Roberto-Garica-Sanchez/tesis/doc control PID.docx

Implementación control PID en Seguidor solar

Para controlar el seguidor solar ya tenemos el Angulo de la hora actual, derivado de los cálculos previamente expuestos, ahora es necesario hacer que el seguidor solar se posiciones en el Angulo para ello se requieres transmitirle esa información al motor y posicione correctamente.

Para lograr este objetivo se requiere la implementación un control PID (Proporcional Integral y Derivativo) que se encargara que el Angulo se mantenga constante y un sistema conversor que transmite los valores a la etapa de potencia que controla el motor (puente H)

El funcionamiento del PID depende de 2 variable de entrada

- Angulo deseado (Angulo de orientación solar)
- Angulo real (Angulo en el que el panel solar esta actualmente)

Estas variables son analógicas y pueden tomar valores que van desde 0 a 5 voltios

Para tal fin se hace uso del módulo analógico que los PIC integran, este modulo convierte el voltaje en una secuencia binaria, de 8 o 10 bits según se configure el módulo.

Según sea la cantidad de bits a utilizar, será mayor o menor la resolución de la lectura y por ende la precisión

Si utilizamos 8 bits solo podemos realizar 254 valores entre 0 a 5 voltios

En cambio 10 bits nos permiten 1024 valores entre 0 a 5 voltios

En este caso se usan 10 bits permitiendo mayor resolución y por ende mejor precisión.

Un inconveniente de usar este módulo, los valores almacenados en formato de bits, no son imprácticos al realizar todas las operaciones del PID que opera utiliza valores de tipo Float. Por lo tanto, se procede a convertir los bits en valores Float.

Para resolver este inconveniente se realizó la conversión de formato binario a Float al realizando una operación y obtener el voltaje y almacenarlo en el formato necesario utilizando la siguiente formula.

voltaje de entrada=(maximo voltaje de entrada*valor de lectura)/(resolucion)

voltaje de entra=(5v*lectura)/1024

################################definicion de PID

################################# ecuaciones PID

- e=error Actual
- k=número de muestra
- t=periodo de muestreo
- kp=Ganancia Proporcional
- ki=Ganancia integral
- kd=Ganancia derivativa
- u=resultado

(u_((s)))/(e_((s)))=[(k_p s+k_i)/s+k_d ]*s

(u_((s)))/(e_((s)))=(k_p s+k_i +k_d s^2)/s s=(1-z^(-1))/t

(u_((s)))/(e_((s)))=(k_p [(1-z^(-1))/t]+k_i +k_d [(1-z^(-1))/t]^2)/([(1-z^(-1))/t])

(u_((s)))/(e_((s)))=((k_p (1-z^(-1) )+k_i t)/t+k_d ((1-z^(-1) ))/t^2)/([(1-z^(-1))/t])

(u_((s)))/(e_((s)))=((k_p (1-z^(-1) )t^2 +k_i t^3 +k_d (1-z^(-1) )^2 t)/(t^3))/([(1-z^(-1))/t])

(u_((s)))/(e_((s)))=((k_p (1-z^(-1) )t^2 +k_i t^3 +k_d (1-z^(-1) )^2 t)/(t^2))/((1-z^(-1) ))

(u_((s)))/(e_((s)))=((k_p (1-z^(-1) )t^2)/(t^2)+(k_i t^3)/(t^2)+(k_d (1-z^(-1) )^2 t)/(t^2))/((1-z^(-1) ))

(u_((s)))/(e_((s)))=(k_p (1-z^(-1) )+k_i t+(k_d)/t(1-z^(-1) )^2)/((1-z^(-1) ))

(u_((s)))/(e_((s)))=(k_p (1-z^(-1) )+k_i t+(k_d)/t(1-2z^(-1) +z^(-2) ))/((1-z^(-1) ))

(u_((s)))/(e_((s)))=((k_p -k_p z^(-1) )+k_i t+((k_d)/t-2z^(-1) +(k_d)/tz^(-2) ))/((1-z^(-1) ))

(u_((s)))/(e_((s)))=((k_p +k_i t+(k_d)/t)+z^(-1) (-2(k_d)/t-k_p )+z^(-2) ((k_d)/t))/((1-z^(-1) ))

z^(-1) [(u_((s)))/(e_((s)))=((k_p +k_i t+(k_d)/t)+z^(-1) (-2(k_d)/t-k_p )+z^(-2) ((k_d)/t))/((1-z^(-1) ))]

z^(-1) [u_((s)) (1-z^(-1) )=e_((s)) ((k_p +k_i t+(k_d)/t)+z^(-1) (-2(k_d)/t-k_p )+z^(-2) ((k_d)/t))]

z^(-1) [u_((s)) -u_((s)) z^(-1) =e_((s)) (k_p +k_i t+(k_d)/t)+e_((s)) z^(-1) (-2(k_d)/t-k_p )+e_((s)) z^(-2) ((k_d)/t)]

u_([k]) -u_([k-1]) =e_([k]) (k_p +k_i t+(k_d)/t)+e_([k-1]) (-2(k_d)/t-k_p )+e_([k-2]) ((k_d)/t) u_([k]) =e_([k]) (k_p +k_i t+(k_d)/t)+e_([k-1]) (-2(k_d)/t-k_p )+e_([k-2]) ((k_d)/t)+u_([k-1])

################################definicion de etapa de potencia

#include <18F4550.h>

#device ADC=10

#fuses XT,NOWDT,NOPROTECT,NOLVP,PUT,BROWNOUT,INTRC_IO

#use delay(clock=4000000)

#INCLUDE <LCD.C>

#USE STANDARD_IO(A)

#USE STANDARD_IO(B)

#USE STANDARD_IO(C)

#USE STANDARD_IO(D)

#USE STANDARD_IO(E)

//configuraciones entradas/salidas

//entradas

#define PIN_SetPoint 0 //[AN0]Setpoint set_adc_channel(0);

#define PIN_PocitionReal 1 //[AN1]posicion real set_adc_channel(1);

//salidas

//control puente H

//comando de control de giro del motor

//set_pwm1_duty() [RC2]

//set_pwm1_duty() [RC3]

//variables tipo bits

unsigned int16 bits_SetPoint=0;

unsigned int16 bits_PocitionReal=0;

unsigned int16 bits_difer=0;

unsigned int16 bits_RES=0;

//variable control PWM

int16 duty=0;

int Timer2,Poscaler;

//variable control giro motor

int cambio, giro=1;//giro 1 si es negativos los valores

//######### PID

float Var_SetPoint=0;

float Var_PocitionReal=0;

float Var_error_0=0;

float Var_error_1=0;

float Var_error_2=0;

float a,b,c; //variables temporales

float t=1; //periodo de muestreo

int k=0; //contador de muestras

float Var_res_0; //Salidas

float Var_res_1; //Salidas

//######### ganancias

float kp=1; //proporcional

float kd=0.2; //Derivativa

float ki=0.2; //integral

vid main() {

Timer2=249; //Se carga Timer 2 con 249

Poscaler=1; //Preescaler solo puede tomar valores de: 1

//Configuración de Timer 2 para establecer frec. PWM a 1kHz

setup_timer_2(t2_div_by_4,Timer2,Poscaler);

setup_ccp1(ccp_pwm); //Configurar modulo CCP1 en modo PWM

setup_ccp2(ccp_pwm); //Configurar modulo CCP2 en modo PWM

//Configurar ADC configuración

//de los puertos que funcionan en analógico

setup_adc_ports(allánalo);

setup_adc(adc_clock_internal);

LCD_INIT(); //Inicializa el LCD

LCD_PUTC("\f"); //Borrar el contenido del LCD

while(true){

//leer Setpoint

set_adc_channel(PIN_SetPoint);//selecciona valore deseado setpoint

delay_us(100);

bits_SetPoint=read_adc();

//leer posición real

set_adc_channel(PIN_PocitionReal); //seleciona la posicion real

delay_us(100);

bits_PocitionReal=read_adc(); //leer

//cálculos

//convierte los bits en voltaje

Var_SetPoint = (5.0*bits_SetPoint)/1024.0;

Var_PocitionReal = (5.0*bits_PocitionReal)/1024.0;

bits_difer=bits_PocitionReal-bits_SetPoint;

//diferencia de voltaje

c=Var_PocitionReal-Var_SetPoint;

//PID cálculos

Var_error_2=Var_error_1;

Var_error_2=Var_error_0;

Var_error_0=Var_PocitionReal-Var_SetPoint;

//calculo

a=Var_error_0*( kp + (ki*t) )+( kd/t );

b=Var_error_1*( (-2*(kd/t) - kp) );

c=Var_error_2*( (kd/t) +Var_res_1 );

Var_res_1=Var_res_0;

Var_res_0=a+b+c;

//conversión para PWM

if(Var_res_0<0){//control de giro

Var_res_0=Var_res_0*-1;

giro=2;

}else{giro=1;}

if(Var_res_0>=4.90){//control contra desbordamiento

Var_res_0=4.99;

}

bits_RES = (1024*Var_res_0) /5;

//incremento en contador

k=k+1;

//interfaz

LCD_GOTOXY(1,1);

printf(lcd_putc," %4Lu",bits_difer); lcd_putc("b");

printf(lcd_putc," %f",Var_error_0); lcd_putc("V");

LCD_GOTOXY(1,2);

printf(lcd_putc," %4Lu",bits_RES); lcd_putc("b");

printf(lcd_putc," %f",Var_res_0); lcd_putc("V");

delay_ms(100);

LCD_PUTC("\f"); //Borrar el contenido del LCD

// EL SISGUIENTE CODIGO SE ENCARGA DE CONVERTIR

// el valor de salida del pid en valores validos

// para el puente h de dos hilos el sentido

// de giro se definirá por el signo ->0<+

if(Var_PocitionReal<Var_SetPoint){//valores positivos

c=Var_SetPoint-Var_PocitionReal;

set_pwm1_duty(bits_RES); //write salida de señal PWM

output_high(PIN_B1); //led indicador de giro

}else{

output_low(PIN_B1);

set_pwm1_duty(0);

}

if(Var_PocitionReal>Var_SetPoint){ //valores negativos

c=Var_PocitionReal-Var_SetPoint;

set_pwm2_duty(bits_RES); //write salida de señal PWM

output_high(PIN_B2); //led indicador de giro

}else{

output_low(PIN_B2);

set_pwm2_duty(0);

} //si el sentido de giro no corresponde apaga el led y PWM

if(Var_SetPoint==Var_PocitionReal){

set_pwm2_duty(0);

set_pwm1_duty(0);

}

}

}
