Roberto-Garica-Sanchez/tesis/observasiones doc tesis.docx

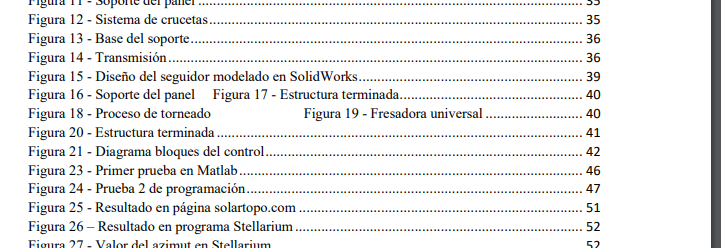
[picture p4: figure]
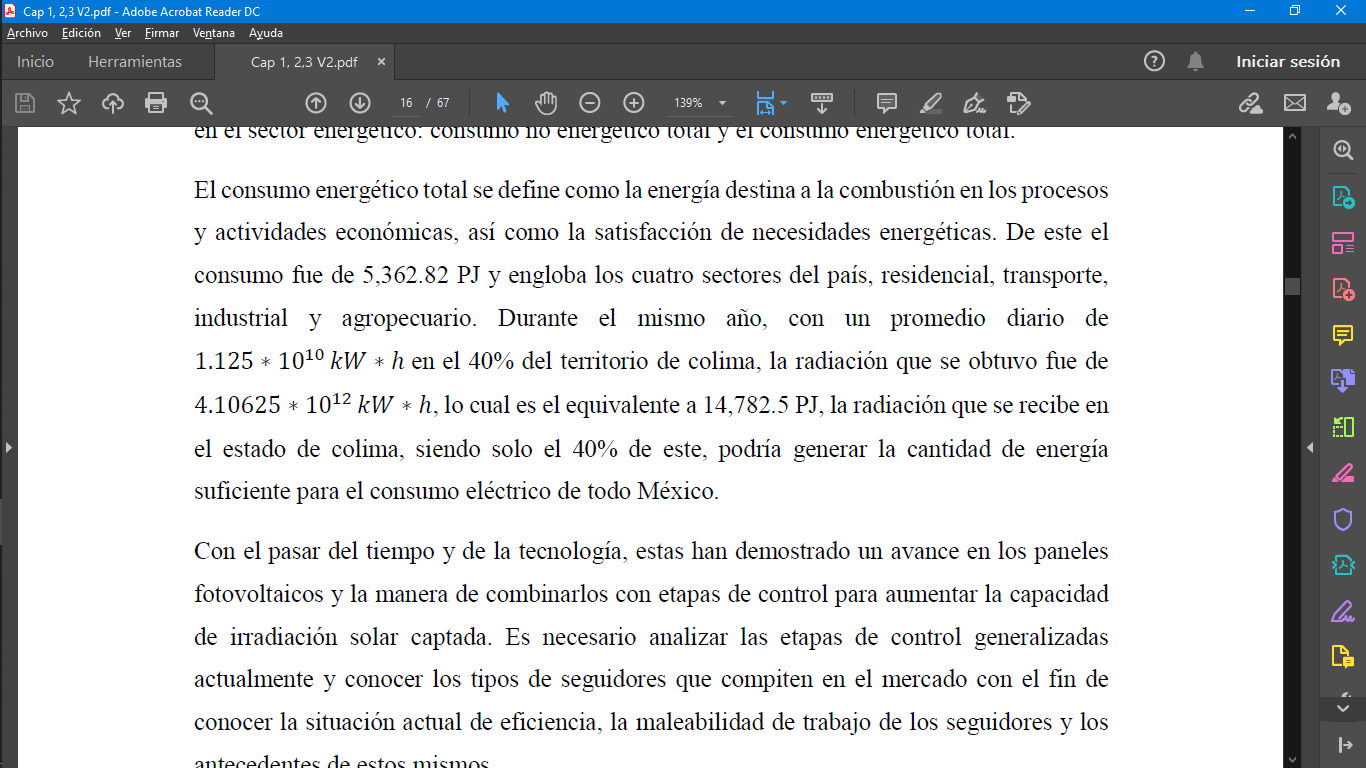
[picture p5: figure]

Actualizar las imágenes

Actualizar el tipo de motor usado y datos relacionados

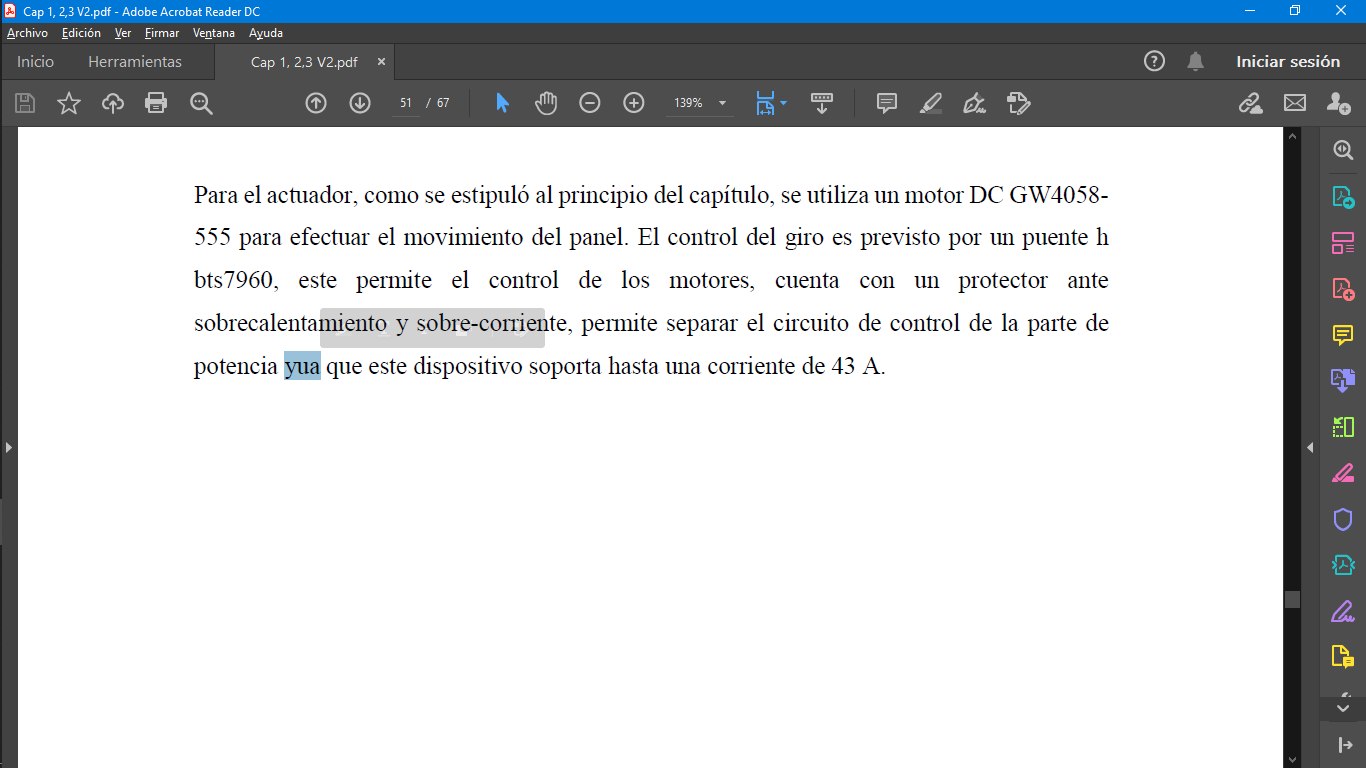
[picture p6: figure]
