Roberto-Garica-Sanchez/tesis/cap 1,2,3 firmado.pdf

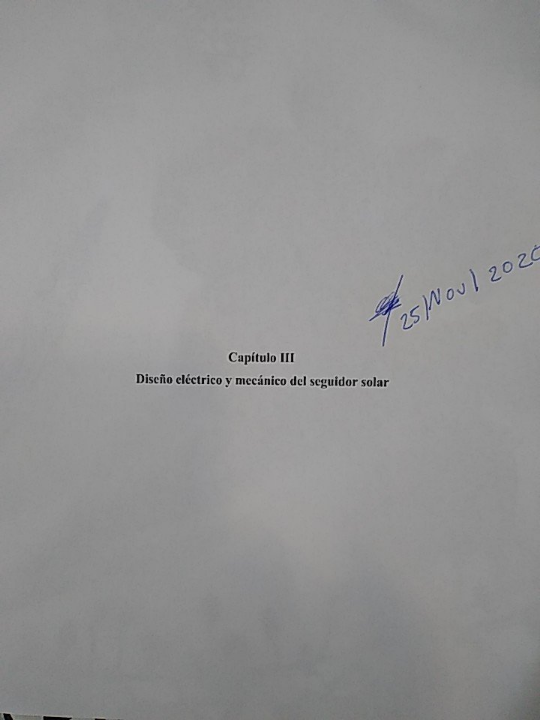
[picture p39: page 1]
