Roberto-Garica-Sanchez/tesis/firmas cap 1 y 2.pdf

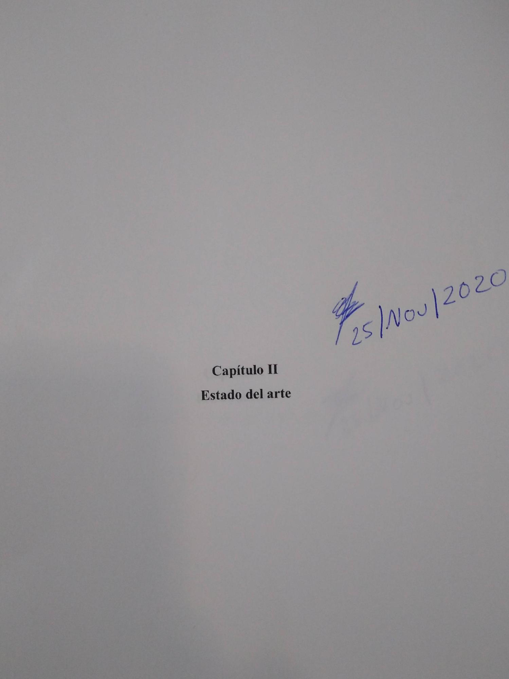
[picture p77: page 1]

Scanned by TapScanner

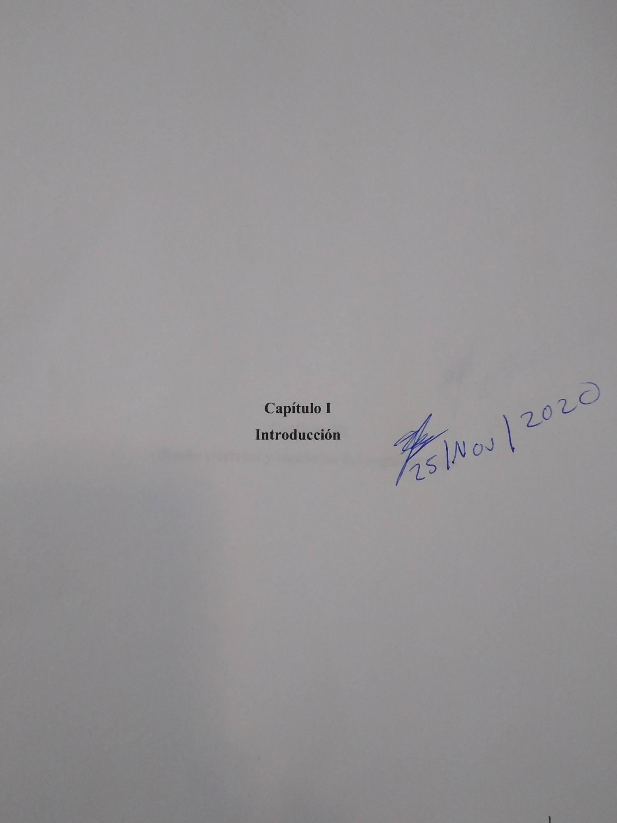
[picture p78: page 2]

Scanned by TapScanner
