Roberto-Garica-Sanchez/tesis/firmas cap2 .pdf

Scanned by TapScanner
