Roberto-Garica-Sanchez/tesis/firma cap 3.gif

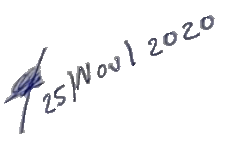
firma cap 3.gif
