Roberto-Garica-Sanchez/tesis/LCD/prote/Sin título.png

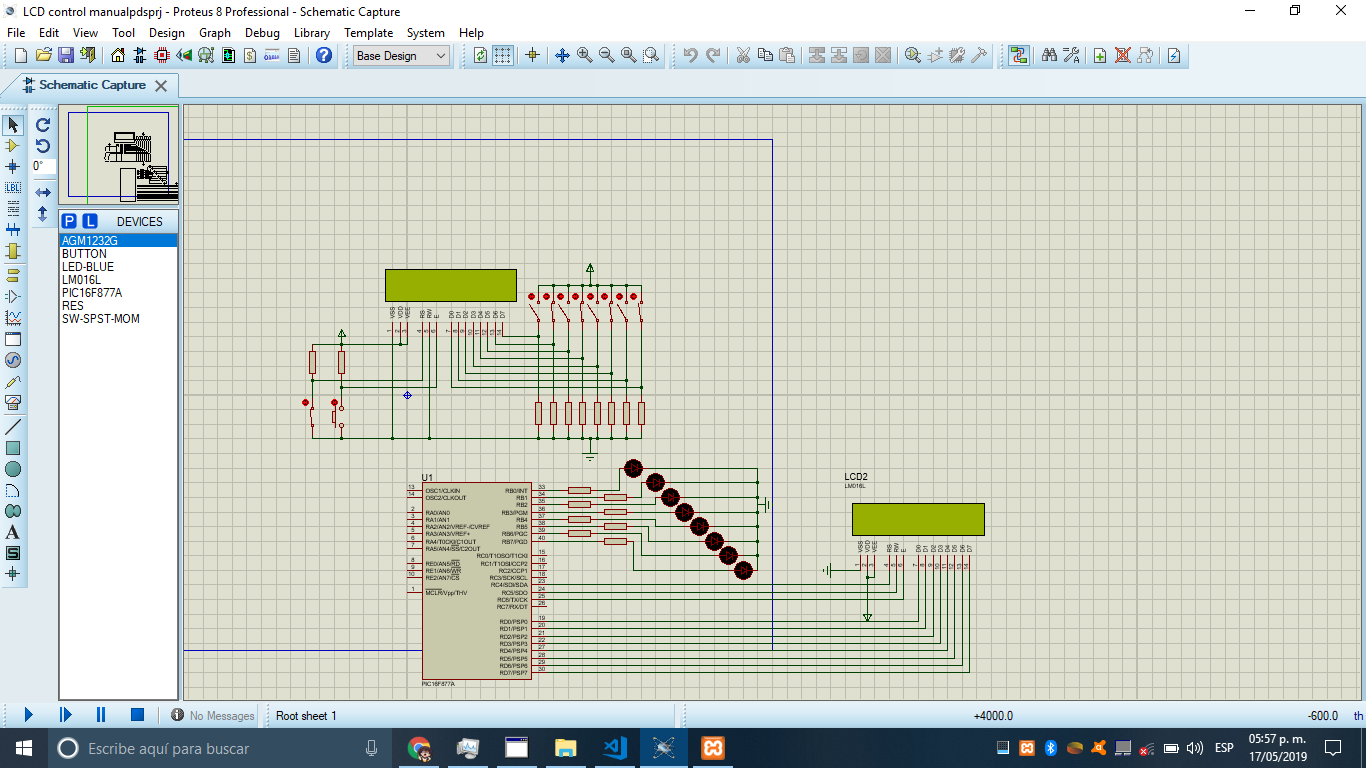
LCD/prote/Sin título.png
