Roberto-Garica-Sanchez/tesis/(list of files, drawings)

Other design files:
4 PWM/prote/4 PWM.pdsprj
LCD con libreria/prote/LCDt.pdsprj
LCD/prote/menu LCDt.pdsprj
PID + PWM2/punte h/PUNTE H.pdsprj
PID + PWM4/prote/PID+ 4 PWM.pdsprj
PID/proteus/PID.pdsprj
PID_PWM2/PUENTE H + PID + LCD + GPS + PCB/PUENTE H + PID + LCD + GPS + PCB.pdsprj
punte h/PUNTE H.pdsprj
PWM 2 hilos/prote puente h/PUNTE H.pdsprj
PWM/proteus/PWM.pdsprj
