Roberto-Garica-Sanchez/tesis/(commit log)

2021-01-03 inico de respaldo
    [New Project.pdsprj]
2021-01-05 finalzado el pid + PWM 1 hilo
    [New Project.pdsprj]
2021-01-07 reinicio de programacion
    se añadio LCD
    [New Project.pdsprj, PID+ 4 PWM.pdsprj, PID.pdsprj, PWM.pdsprj, menu LCDt.pdsprj]
2021-01-07 punte h corregido
    [PUNTE H.pdsprj]
2021-01-08 punte h + PWM 2 hilos
    versión de programas para probar un puente h con 2 señales pwm
    [PUNTE H.pdsprj]
2021-01-09 calibracion punte H + PWM 2 hilos
    se ajustaron las condiciones para que el que al igualarse los potencio-metros este se detnga y al medir diferencia de gire según la dirección en caída
2021-01-10 LCD libreria add
    [LCDt.pdsprj]
2021-01-10 PID + LCD + PWM 2hilos terminado pendiente ajustes ganancias
    [PID+ 4 PWM.pdsprj, PUNTE H.pdsprj, menu LCDt.pdsprj]
2021-01-11 update puente H IRL520
    [PUNTE H.pdsprj]
2021-01-12 PID + PWM2 intregacion de GPS y baquelita
    [PUNTE H.pdsprj]
2021-01-18 Conversion de programa
    [PUENTE H + PID + LCD + GPS + PCB.pdsprj]
2021-01-18 conversion 90 %
    [PUENTE H + PID + LCD + GPS + PCB.pdsprj]
